stefan3n/toycar-2025/JetsonControl/aiModels/README.md

# yolov10.pt            - normal yolo
# yolov10n_trained.pt   - trained yolov10n on [SERP](https://universe.roboflow.com/serp-plastic-bottles-9o4su/serp-plastic-bottles-fjj56) bottles dataset
# yolov10b_trained.pt - trained yolov10b on [SERP](https://universe.roboflow.com/serp-plastic-bottles-9o4su/serp-plastic-bottles-fjj56) bottles dataset
