stefan3n/toycar-2025/JetsonControl/doc2024/Misc/Flashing.md

### [< back](../GuideForDocumentation.md)
# SD Card flash with a new image

### !!! Use a minimum 64GB SD card !!! 32GB is not enough, and even 64GB cuts it close once you install everything.

## For this step go to the this [link](https://www.jetson-ai-lab.com/initial_setup_jon.html#__tabbed_1_1). After do this steps:
### 1. Download Jetpack 5.1.3 image. (for *Jetson Nano*, the older one, the version is 4.6)
### 2. Install Balena Etcher.
### 3. After installing Balena Etcher, open it, select the downloaded image.
### 4. Select the SD card.
### 5. Flash the card.
### 6. Insert the SD card in Jetson Orin Nano, and connect it to a monitor.
### 7. Start the Jetson Orin Nano, after rebooting it to install the latest updates.
