stefan3n/toycar-2025/JetsonControl/doc2024/GuideForDocumentation.md

#  Car Documentation Guide

## 1. Introduction information
- [Car Description](CarDescription.md)
- [ReadMe](README.md)
- [Good to know](GoodToKnow.md)
- [Code Flow](CodeFlow.md)
- [Resource Monitoring](ResourceMonitoring.md)

## 2. Motors

- [Motor Control](Motors/Motor_control.md)

## 3. Robot 
- [Arm control pinout](Robot/Arm_control_pinout.md)
- [Driver and Stepper](Robot/Driver_and_Stepper.md)
- [Grab a bottle](Robot/Grab_a_bottle.md)
- [H_Bridge](Robot/HBridge.md)
- [Inverse kinematics](Robot/Inverse_kinematics.md)
- [Moving the arm](Robot/Moving_the_arm.md)
- [Servo.md](Robot/Servo.md)

## 4. Battery

- [Battery](Battery/Battery.md)

## 5. Visual 
- [Camera](Visual/Camera.md)
- [Camera calibration](Visual/CameraCalibration.md)
- [AI](Visual/AI.md)
- [Train AI](Visual/Train_AI.md)

## 6. Misc
- [Back-up.md](Misc/Back-up.md)
- [Flashing](Misc/Flashing.md)
- [Process](Misc/Process.md)
- [Remote connection](Misc/Remote_connection.md)
- [Serial](Misc/Serial.md)

## 7. Navigation
- [Cartographer SLAM](Navigation/Cartographer_SLAM.md)
- [Configuring move_base](Navigation/Configuring_move_base.md)
- [IMU](Navigation/IMU.md)
- [ROS setup](Navigation/ROS_setup.md)
- [SLAM with IMU](Navigation/SLAM_with_IMU.md)

## 8. Serial Communication
- [Arduino Serial](SerialCommunication/ArduinoSerial.md)

## 9. To do
- [Improvement and Ideas](Improvement_and_Ideas.md)
