stefan3n/toycar-2025/JetsonControl/doc2024/Visual/CameraCalibration.md

### [< back](../GuideForDocumentation.md)
## To calibrate the cameras, refer to this [file](../../tests/cameraCalib.py).
## EDIT: We have removed calibration (it was not that useful for the usb cameras)
