stefan3n/toycar-2025/JetsonControl/main/teleop.py

Pentru a integra un senzor IMU (cu giroscop și accelerometru) în sistemul tău ROS2 și a îmbunătăți odometria pentru SLAM, trebuie să publici datele IMU, să le fuzionezi cu odometria existentă (din `tf_publisher_node` sau encoder-ele roților) și să folosești un filtru precum `robot_localization` pentru a obține o estimare mai precisă a poziției robotului. Acest lucru va reduce eroarea „Message Filter dropping message” și va preveni „pierderea” robotului în timpul explorării. Iată pașii conciși pentru integrarea IMU:

---

### **Pași pentru integrarea senzorului IMU**

#### **1. Configurează driverul IMU**
- **Identifică senzorul IMU**: Presupun că ai un senzor IMU (ex. MPU-6050, BNO055) conectat la Jetson Nano sau Arduino.
- **Instalează driverul ROS2**:
  - Pentru MPU-6050 sau alte IMU-uri comune, folosește pachetul `imu_tools` sau `rtabmap_ros`:
    ```bash
    sudo apt install ros-<distro>-imu-tools
    ```
    Înlocuiește `<distro>` cu distribuția ta (ex. `humble`).
  - Dacă IMU-ul este conectat la Arduino, configurează Arduino să trimită datele (ex. unghiuri Euler sau quaternion) prin serial și creează un nod ROS2 pentru a le publica.

- **Publică datele IMU**:
  - Creează un nod ROS2 (ex. `imu_node.py`) pentru a publica datele IMU pe topicul `/imu/data` (de tip `sensor_msgs/Imu`):
    ```python
    import rclpy
    from rclpy.node import Node
    from sensor_msgs.msg import Imu
    import serial
    from tf_transformations import quaternion_from_euler

    class ImuNode(Node):
        def __init__(self):
            super().__init__('imu_node')
            self.imu_publisher = self.create_publisher(Imu, '/imu/data', 10)
            self.serial_port = serial.Serial('/dev/ttyACM1', 115200, timeout=0.1)  # Ajustează portul
            self.timer = self.create_timer(0.01, self.timer_callback)
            self.get_logger().info("IMU node started")

        def timer_callback(self):
            if self.serial_port.in_waiting > 0:
                line = self.serial_port.readline().decode().strip()
                # Presupunem că Arduino trimite: "<roll,pitch,yaw,accel_x,accel_y,accel_z>"
                try:
                    roll, pitch, yaw, ax, ay, az = map(float, line.split(','))
                    imu_msg = Imu()
                    imu_msg.header.stamp = self.get_clock().now().to_msg()
                    imu_msg.header.frame_id = 'imu_link'
                    q = quaternion_from_euler(roll, pitch, yaw)
                    imu_msg.orientation.x = q[0]
                    imu_msg.orientation.y = q[1]
                    imu_msg.orientation.z = q[2]
                    imu_msg.orientation.w = q[3]
                    imu_msg.linear_acceleration.x = ax
                    imu_msg.linear_acceleration.y = ay
                    imu_msg.linear_acceleration.z = az
                    self.imu_publisher.publish(imu_msg)
                except Exception as e:
                    self.get_logger().error(f"Failed to parse IMU data: {e}")

        def destroy_node(self):
            self.serial_port.close()
            super().destroy_node()

    def main(args=None):
        rclpy.init(args=args)
        node = ImuNode()
        try:
            rclpy.spin(node)
        except KeyboardInterrupt:
            pass
        finally:
            node.destroy_node()
            rclpy.shutdown()

    if __name__ == '__main__':
        main()
    ```

  - **Notă**: Ajustează formatul datelor (`roll, pitch, yaw, accel_x, accel_y, accel_z`) și portul serial (`/dev/ttyACM1`) conform setup-ului tău.

- **Adaugă transformarea statică**:
  - Publică transformarea `base_link -> imu_link` (unde IMU-ul este montat pe robot):
    ```python
    Node(
        package='tf2_ros',
        executable='static_transform_publisher',
        name='imu_to_base_link_tf',
        arguments=['0', '0', '0.1', '0', '0', '0', 'base_link', 'imu_link']
    )
    ```
  - Adaugă această linie în `robot_launch.py`.

#### **2. Actualizează `setup.py`**
- Adaugă `imu_node` în `setup.py`:
  ```python
  py_modules=[
      'keyboard_teleop',
      'cmd_vel_listener',
      'tf_publisher_node',
      'navigation_node',
      'imu_node',
  ],
  entry_points={
      'console_scripts': [
          'keyboard_teleop = robot_control.keyboard_teleop:main',
          'cmd_vel_listener = robot_control.cmd_vel_listener:main',
          'tf_publisher_node = robot_control.tf_publisher_node:main',
          'navigation_node = robot_control.navigation_node:main',
          'imu_node = robot_control.imu_node:main',
      ],
  },
  ```

#### **3. Configurează `robot_localization`**
- **Instalează pachetul**:
  ```bash
  sudo apt install ros-<distro>-robot-localization
  ```

- **Creează configurația EKF**:
  - Creează fișierul `ekf_config.yaml` în `~/ros2_ws/src/keyboard_teleop_pkg/config`:
    ```yaml
    ekf_filter_node:
      ros__parameters:
        transform_time_offset: 0.1
        transform_timeout: 0.0
        two_d_mode: true
        map_frame: map
        odom_frame: odom
        base_link_frame: base_link
        world_frame: odom
        odom0: /odom
        odom0_config: [true, true, false, false, false, true, false, false, false, false, false, false, false, false, false]
        odom0_differential: false
        imu0: /imu/data
        imu0_config: [false, false, false, true, true, true, false, false, false, true, true, true, false, false, false]
        imu0_differential: false
        imu0_remove_gravitational_acceleration: true
    ```

  - **Explicație**:
    - Fuzionează datele de la `/odom` (poziție și viteză unghiulară) și `/imu/data` (orientare și accelerație).
    - `two_d_mode: true` presupune că robotul se mișcă doar în plan 2D.

- **Adaugă EKF în `robot_launch.py`**:
  ```python
  Node(
      package='robot_localization',
      executable='ekf_node',
      name='ekf_filter_node',
      parameters=[os.path.join(config_dir, 'ekf_config.yaml')]
  )
  ```

#### **4. Actualizează `robot_launch.py`**
- Asigură-te că fișierul include toate nodurile necesare:
  ```python
  from launch import LaunchDescription
  from launch_ros.actions import Node
  from ament_index_python.packages import get_package_share_directory
  import os

  def generate_launch_description():
      config_dir = os.path.join(get_package_share_directory('keyboard_teleop_pkg'), 'config')
      slam_config = os.path.join(config_dir, 'slam_toolbox_config.yaml')
      ekf_config = os.path.join(config_dir, 'ekf_config.yaml')

      return LaunchDescription([
          Node(
              package='keyboard_teleop_pkg',
              executable='cmd_vel_listener',
              name='cmd_vel_listener'
          ),
          Node(
              package='keyboard_teleop_pkg',
              executable='tf_publisher_node',
              name='tf_publisher_node'
          ),
          Node(
              package='keyboard_teleop_pkg',
              executable='navigation_node',
              name='navigation_node'
          ),
          Node(
              package='keyboard_teleop_pkg',
              executable='imu_node',
              name='imu_node'
          ),
          Node(
              package='slam_toolbox',
              executable='sync_slam_toolbox_node',
              name='slam_toolbox',
              parameters=[slam_config]
          ),
          Node(
              package='tf2_ros',
              executable='static_transform_publisher',
              name='laser_to_base_link_tf',
              arguments=['0', '0', '0.1', '0', '0', '0', 'base_link', 'laser_frame']
          ),
          Node(
              package='tf2_ros',
              executable='static_transform_publisher',
              name='imu_to_base_link_tf',
              arguments=['0', '0', '0.1', '0', '0', '0', 'base_link', 'imu_link']
          ),
          Node(
              package='robot_localization',
              executable='ekf_node',
              name='ekf_filter_node',
              parameters=[ekf_config]
          ),
      ])
  ```

#### **5. Testează sistemul**
1. **Compilează**:
   ```bash
   cd ~/ros2_ws
   colcon build
   source install/setup.bash
   ```

2. **Pornește driverul LIDAR** (dacă nu este inclus în launch):
   ```bash
   ros2 run rplidar_ros rplidar_composition --ros-args -p serial_port:=/dev/ttyUSB0 -p use_time_from_ros:=true
   ```

3. **Rulează launch-ul**:
   ```bash
   ros2 launch keyboard_teleop_pkg robot_launch.py
   ```

4. **Rulează `keyboard_teleop` manual**:
   ```bash
   ros2 run keyboard_teleop_pkg keyboard_teleop
   ```

5. **Verifică datele IMU**:
   ```bash
   ros2 topic echo /imu/data
   ```

6. **Verifică odometria fuzionată**:
   - EKF publică odometria fuzionată pe `/odometry/filtered`:
     ```bash
     ros2 topic echo /odometry/filtered
     ```

7. **Verifică harta în RViz2**:
   ```bash
   ros2 run rviz2 rviz2
   ```
   - Adaugă: `Map` (`/map`), `LaserScan` (`/scan`), `TF`, `Odometry` (`/odometry/filtered`).
   - Mișcă robotul manual și verifică dacă harta este mai stabilă.

8. **Testează `exploration_node`**:
   - Activează explorarea automată și monitorizează `/cmd_vel` și `/odometry/filtered`.

#### **6. Depanare**
- **Dacă harta este instabilă**:
  - Ajustează `imu0_config` în `ekf_config.yaml` pentru a da mai multă greutate datelor IMU (ex. crește `imu0_config` pentru orientare).
  - Redu `minimum_travel_distance` în `slam_toolbox_config.yaml` la `0.1`.

- **Dacă comenzile sunt întârziate**:
  - Verifică utilizarea CPU:
    ```bash
    htop
    ```
  - Redu frecvența datelor IMU sau LIDAR dacă hardware-ul este supraîncărcat.

- **Verifică TF**:
  ```bash
  ros2 run tf2_tools tf2_monitor
  ```
  - Asigură-te că `map -> odom -> base_link -> laser_frame -> imu_link` sunt publicate.

---

### **Următori pași**
- **Îmbunătățește odometria**:
  - Adaugă date de la encoder-ele roților în `cmd_vel_listener` pentru a completa fuziunea datelor.
- **Testează explorarea**:
  - Verifică dacă `exploration_node` folosește `/odometry/filtered` pentru navigație.
- **Depanează întârzierile**:
  - Dacă robotul răspunde lent, ajustează frecvența nodurilor sau optimizează hardware-ul.

Spune-mi ce arată `/odometry/filtered` sau `tf2_monitor`, sau dacă apar alte erori, și te ghidez mai departe!
