stefan3n/toycar-2025/(commit log)

2024-09-13 Add jetson code
    [head_2d.urdf]
2024-09-13 Add arduino_motor code
2024-09-13 Add robot arm arduino code
